CarterTucker/Desktop-Speaker/Optimized Speaker Box.step

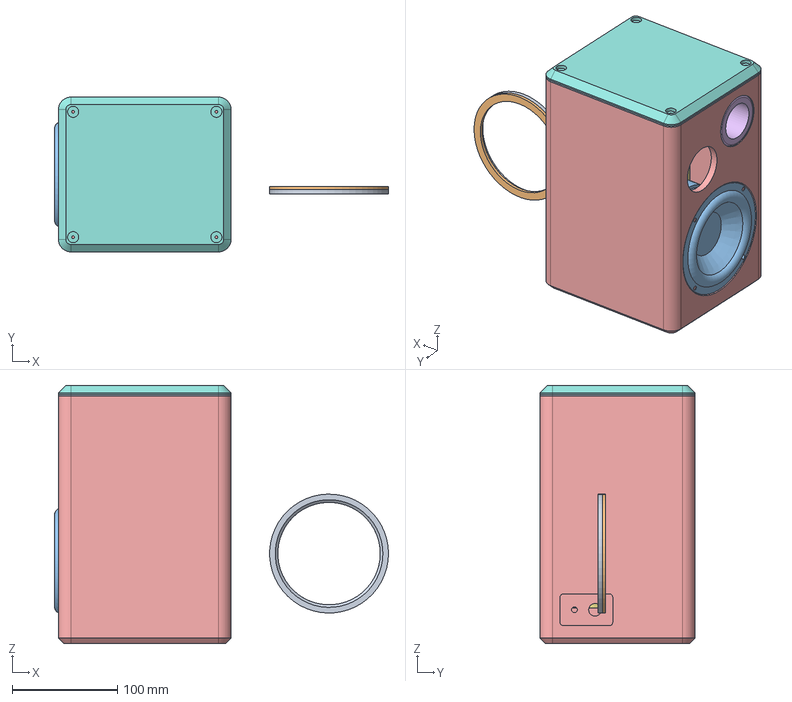
[picture p21: CAD file, 2026-02-25]
Optimized Speaker Box.step
317.2 x 147.0 x 245.0 mm
Main Box
Vent Tube
Speaker Top
Seal
